kimar1022-code/autonomous-exploration-robot/(commit log)

2026-06-01 Initial commit: 펌웨어 + UART 통신 + ROS2 설치까지
2026-06-05 PHASE 2: ROS2 워크스페이스 추가 (PWM 노드, 엔코더 보정)
    [robot.urdf]
2026-06-05 PHASE 2: PWM 펌웨어 추가 (base_controller_pwm.ino)
    - Arduino Nano 33 BLE Sense UART + PWM 속도 제어 펌웨어
    - 프로토콜: M,<left>,<right> (-255~255, 부호=방향/크기=속도)
    - D10/D11 PWM (ENA/ENB), 최소 PWM 100
    - 엔코더 + IMU(가속도/자이로/지자계) 50Hz 송신
    - 0.5초 명령 타임아웃 안전정지
2026-06-05 docs: README 로드맵 업데이트 (Phase 5-7 완료)
    - Phase 5 PWM 속도 제어 완료 표시 (D10/D11, 3.3V 검증)
    - Phase 6 base_controller ROS2 노드 완료 표시 (cmd_vel ↔ UART)
    - Phase 7 URDF + odometry 완료 표시 (엔코더 보정 좌 1971.5 / 우 2196.3)
    - Project Structure: ros2_ws 예정 → 실제 경로로 수정
2026-06-06 Add teleop keyboard control node (cumulative velocity)
2026-06-06 Update README: teleop control, RPLIDAR integration, roadmap progress
    - Mark Phase 5-8 complete (PWM, base_controller, URDF/odometry, teleop + RPLIDAR)
    - Add teleop_node run instructions and RPLIDAR launch command
    - Add power (brownout) and bootloader troubleshooting entries
2026-06-07 PHASE 3: SLAM 준비 — URDF laser 프레임 정리 + slam_toolbox 설정/launch 추가
    - URDF: lidar_link → laser 프레임 통일 (rplidar /scan frame_id 와 일치)
    - URDF: odom 링크 제거 (odom→base_link 은 base_controller 가 동적 발행)
    - config/slam_toolbox.yaml: base_frame=base_link, max_laser_range=12.0 (A1M8)
    - launch/slam.launch.py: 데스크탑용 SLAM 한 줄 실행
    - setup.py: config/ 설치 등록
    - NOTES.md, .feature/skills/lint 추가
    [robot.urdf]
2026-06-07 SLAM 동작화: lifecycle launch 수정 + HuberLoss 튜닝으로 맵 품질 개선
    - slam.launch.py: Jazzy LifecycleNode 대응 — 공식 online_async_launch include
    (일반 Node 로 띄우면 초기화에서 멈추는 문제 해결) + lidar_link→laser TF 다리 포함
    - config/slam_toolbox.yaml: 자작 차동구동 튜닝
    ceres_loss_function=HuberLoss(바퀴 슬립 강건), minimum_travel_heading=0.1(회전 드리프트↓),
    minimum_travel_distance=0.2 → 부챗살 번짐 대부분 제거, 벽 윤곽 또렷
    - config/ekf.yaml: robot_localization IMU 융합 설정 (준비, 아직 미연결)
    - NOTES.md: 로봇 IP 현행화(192.168.75.100, DHCP) + Pi 워크스페이스 메모
2026-06-07 docs: 실행순서.md 추가 — SLAM 매핑 터미널 5창 + 지도 저장 명령 정리
2026-06-07 Nav2 주행 가능화: base_controller 데드밴드+TF양보+covariance, EKF/collision_monitor 설정
    - base_controller.py: 데드밴드(MIN_PWM=100), publish_tf 파라미터(EKF에 TF 양보), odom/imu covariance
    - slam.launch.py: EKF(robot_localization) 통합 — IMU 융합
    - config/nav2_params.yaml: robot_radius=0.15, collision_monitor 일시 비활성
    - config/ekf.yaml, launch/nav2.launch.py 추가
    [base_controller.py]
2026-07-27 README 정리(깨진 코드펜스 수정), 내부 작업 문서 제거
2026-07-27 제목 영문 통일
2026-07-27 테스트·mock 파일 정리
2026-08-22 docs: 로봇 실물 사진 추가 (4면)
    상단 대표 사진과 Getting Started 의 하드웨어 실물 절에 좌/우/앞/위 4면을 넣었다.
    1200px JPEG 로 줄여 4장 합계 330KB.
2026-10-05 문서: 줄표와 가운데점 표기 통일
2026-10-05 문서: README 사진 · 표를 본문 폭에 맞춤
2026-10-05 문서: 짧은 표도 본문 폭까지 늘어나도록 보정
2026-10-05 문서: 구조도가 GitHub에서 깨지던 문제 수정 (반대 방향 화살표를 양방향 하나로)
2026-10-05 문서: 구조도를 팀 프로젝트와 같은 스타일 그림으로 교체
